DP-INVENTIONS/DP-Ventilator/README.md

# DP-Ventilator
Open Source BVM based ventilator
