DP-INVENTIONS/DP-Ventilator/DPvent 23052020 BOM.xlsx

VENTILATOR
ITEM NO. | PARTGROUP | PART NUMBER | Reseller | PRICE | DESCRIPTION | QTY. | Total
1 | Front | NX4827K043_011R | Tinytronics | 56 | Nextion touchscreen 4.3" 480x272 65536 colors | 1 | 56
2 | Front | KY-040 | Aliexpress | 1 | Rotary encounter EC11 20mm with push button on pcb | 1 | 1
3 | Front | KNOPBKWH | Tinytronics | 0.5 | Button knob (white) | 1 | 0.5
4 | Front | CKN12299-ND | Digikey | 6.63 | SWITCH ANTIVANDAL 16MM DOME RING | 1 | 6.63
5 | Front | NgenGray 1.75 | OMD3D | 40 | canvas layer Ngen filament gray | 0.1 | 4
6 | Front | NgenGray 1.75 | OMD3D | 40 | Front layer Ngen filament gray | 0.1 | 4
7 | Cabinet | NSYTBS241912H | Farnell | 20.8 | Schneider Thalassa PLS enclosure 241 mm, 194 mm, 127 mm, IP66 | 1 | 20.8
8 | Cabinet | RDMEGAXPRO-USBB | Tinytronics | 15 | RobotDyn MegaXPRO R3 - Compatible - USB-B | 1 | 15
9 | Cabinet | DCDCSTEPDOWN5V | Tinytronics | 3 | DC-DC Step-down Buck Converter 1.5A - 5V output | 1 | 3
10 | Cabinet | EB40202S2-999 | Tinytronics | 5 | Sunon Ventilator 40x40x20mm - 24V | 1 | 5
11 | Cabinet | 5VBUZMOD | Tinytronics | 1.5 | Actieve Buzzer Module 5V | 1 | 1.5
12 | Cabinet | DC5.5FMOUNT | Tinytronics | 0.5 | DC Jack plastic 5.5mm - Female - Mount | 1 | 0.5
13 | Cabinet | RJ45 socket | Aliexpress | 2 | RJ45 Waterproof Connector Female Panel Mount Sockets Ethernet Straight | 1 | 2
14 | Cabinet | 2278 | DamenCNC | 108.89 | Leadshine Digital Stepper Drive DM856 80V 5,6A (2phase) | 1 | 108.89
15 | Cabinet | 674 | DamenCNC | 114.94 | Stepper Motor DCNC-NEMA34-4.5Nm (Double Shaft) | 1 | 114.94
16 | Cabinet | NgenBlack 1.75 | OMD3D | 40 | Mechanic strap system | 0.5 | 20
17 | Cabinet | NgenWhite 1.75 | OMD3D | 40 | Cover pieces | 0.5 | 20
18 | Cabinet | Axe 8mm | 123 3Dprint | 22.5 | Lineare axe 8x500mm | 1 | 22.5
19 | Cabinet | Bearing 608ZZ | 123 3Dprint | 6 | 10 bearings 608ZZ | 1 | 6
20 | Cabinet | Screws | Tinytronics | 5 | Set screws | 1 | 5
21 | Cabinet | Power switch | 123 3Dprint | 4 | Schakelaar SPST 5A 250V voor paneelmontage | 1 | 4
22 | Power | GST120A24-P1M | Meanwell | 36.6 | AC-DC adaptor with PFC; Output 24Vdc at 5A; 3 pole AC inlet IEC320-C14 | 1 | 36.6
23 | Cabinet | Springs | 123 3Dprint | 2.5 | Schakelaar SPST 5A 250V voor paneelmontage | 4 | 10
24 | Cabinet | NgenWhite 1.75 | Meanwell | 15 | Springhouse left and right | 1 | 15
25 | Cabinet | Strapbelt | - | 7 | Strap witdh 20mm/ 1mm thick | 1 | 7
 |  |  |  |  |  | Totaal | 489.86
 |  |  |  |  |  |  | Estimated cost
Printed parts
ITEM NO. | PARTGROUP | MATERIAL | Alternatif | Time to build | DESCRIPTION | QTY. | Total
5 | Front | NgenGray 1.75 | - | 15:00:00 | Front canvas | 1 | 15:00:00 | 15
6 | Front | NgenGray 1.75 | Lasercut | 3:00:00 | Front | 1 | 3:00:00 | 3
16 | Cabinet | NgenBlack 1.75 | Lasercut | 5:30:00 | table | 1 | 5:30:00 | 5.5
16 | Cabinet | NgenBlack 1.75 | Lasercut | 8:30:00 | Motorplate | 1 | 8:30:00 | 8.5
16 | Cabinet | NgenBlack 1.75 | Lasercut | 9:40:00 | Gearplate | 1 | 9:40:00 | 9.5
16 | Cabinet | NgenGray 1.75 | cute out of tube | 5:00:00 | 4 guiding Rolls | 1 | 5:00:00 | 5
16 | Cabinet | NgenGray 1.75 | CNC | 1:40:00 | Gearing roll | 1 | 1:40:00 | 1.5
16 | Cabinet | Ngenblack 1.75 | Lasercut | 3:30:00 | Plate holders and covers | 1 | 3:30:00 | 3.5
17 | Cabinet | NgenWhite 1.75 | Lasercut | 13:40:00 | Top plate cover enclosure + tube holders left right | 1 | 13:40:00 | 13.5
17 | Cabinet | NgenWhite 1.75 | - | 2:40:00 | Underbow tube | 1 | 2:40:00 | 2.5
17 | Cabinet | NgenWhite 1.75 | - | 7:30:00 | Bridgepusher | 1 | 7:30:00 | 7.5
17 | Cabinet | NgenWhite 1.75 | - | 2:00:00 | Bridgetopplate | 1 | 2:00:00 | 2
17 | Cabinet | NgenWhite 1.75 | - | 2:00:00 | Bridge strapholders | 1 | 2:00:00 | 2
17 | Cabinet | NgenGray 1.75 | Lasercut | 6:40:00 | Bridge pilars | 1 | 6:40:00 | 7
24 | Cabinet | NgenWhite 1.75 | - | 13:00:00 | Spring houses | 1 | 13:00:00 | 13
 |  |  |  |  |  | Totaal | 99.00
 |  |  |  |  | Could be less if some parts will be laser cutted |  | Printing hours
BATTERY BACKUP
ITEM NO. | PARTGROUP | PART NUMBER | Reseller | PRICE | DESCRIPTION | QTY. | Total
26 | Front | TM1683 | Tinytronics | 9 | Led/Key board | 1 | 9
27 | Front | NgenGray 1.75 | OMD3D | 40 | canvas layer Ngen filament gray | 0.1 | 4
28 | Front | NgenGray 1.75 | OMD3D | 40 | Front layer Ngen filament gray | 0.1 | 4
29 | Cabinet | NSYTBS241910H | Farnell | 20.8 | Schneider Thalassa PLS enclosure 241 mm, 194 mm, 80 mm, IP66 | 1 | 20.8
30 | Cabinet |  | Tinytronics | 15 | RobotDyn UNO - Compatible - USB-B | 1 | 15
31 | Cabinet | DCDCSTEPDOWN5V | Tinytronics | 3 | DC-DC Step-down Buck Converter 1.5A - 5V output | 1 | 3
32 | Cabinet | EB40202S2-999 | Tinytronics | 5 | Sunon Ventilator 40x40x20mm - 24V | 1 | 5
33 | Cabinet | 5VBUZMOD | Tinytronics | 1.5 | Actieve Buzzer Module 5V | 1 | 1.5
34 | Cabinet | DC5.5FMOUNT | Tinytronics | 0.5 | DC Jack plastic 5.5mm - Female - Mount | 1 | 0.5
35 | Cabinet | Power switch | 123 3Dprint | 4 | Schakelaar SPST 5A 250V voor paneelmontage | 1 | 4
36 | Cabinet | Battery | - | 24 |  | 2 | 48
37 | Cabinet | DCDC supply UPS | 123 3Dprint | 45 |  | 1 | 45
38 | Cabinet | NgenBlack 1.75 | OMD3D | 2 | Feets Ngen filamennt black | 1 | 2
39 | Cabinet | Screws | Tinytronics | 2 | Set screws | 1 | 2
 |  |  |  |  |  | Totaal | 163.8
 |  |  |  |  |  |  | Estimated cost
Printed parts
ITEM NO. | PARTGROUP | MATERIAL | Alternatif | Time to build | DESCRIPTION | QTY. | Total
24 | Front | NgenGray 1.75 | - | 15:00:00 | Front canvas | 1 | 15:00:00 | 15
24 | Front | NgenGray 1.75 | - | 3:00:00 | Front | 1 | 3:00:00 | 3
38 | Cabinet | NgenBlack 1.75 | - | 2:00:00 | Voetjes | 1 | 2:00:00 | 2
 |  |  |  |  |  | Totaal | 20.00
 |  |  |  |  |  |  | Printing hours
