DP-INVENTIONS/DP-Ventilator/stl/HAAKJE.stl

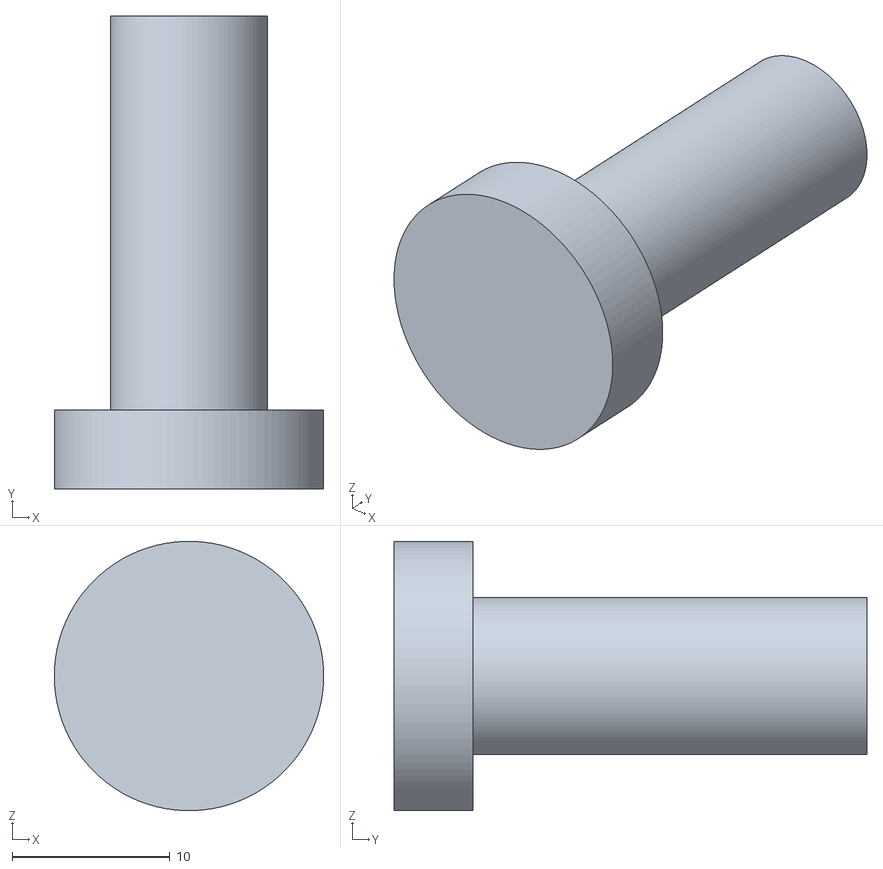
[picture p1: CAD file, 2020-05-24]
stl/HAAKJE.stl
17.1 x 30.0 x 17.1
