DP-INVENTIONS/DP-Ventilator/stl/TAFEL2.stl

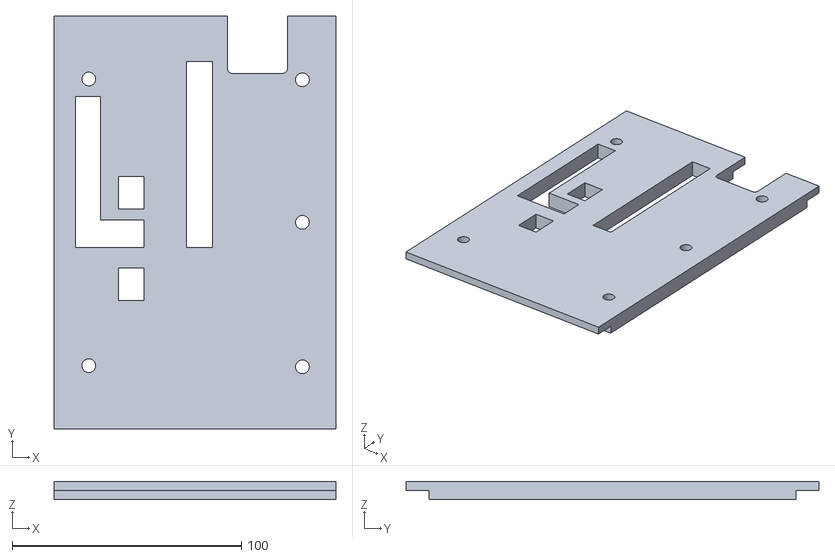
[picture p2: CAD file, 2020-05-24]
stl/TAFEL2.stl
122.9 x 180.1 x 8.00
