DP-INVENTIONS/DP-Ventilator/stl/CLIPS.stl

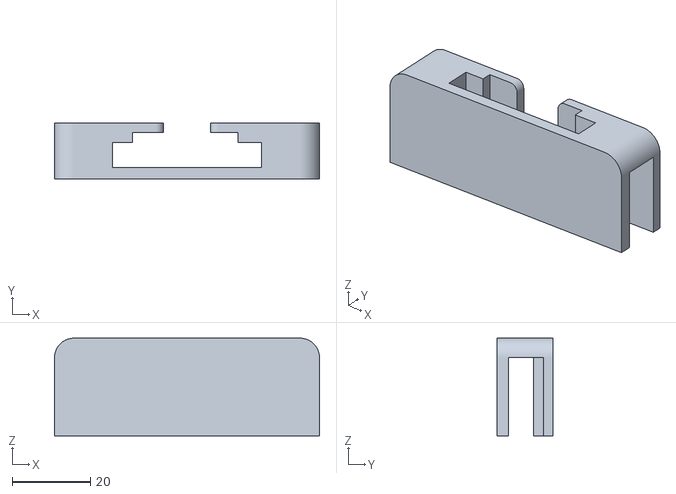
[picture p3: CAD file, 2020-05-24]
stl/CLIPS.stl
67.8 x 14.4 x 25.0
