DP-INVENTIONS/DP-Ventilator/stl/BALGSTEUN.stl

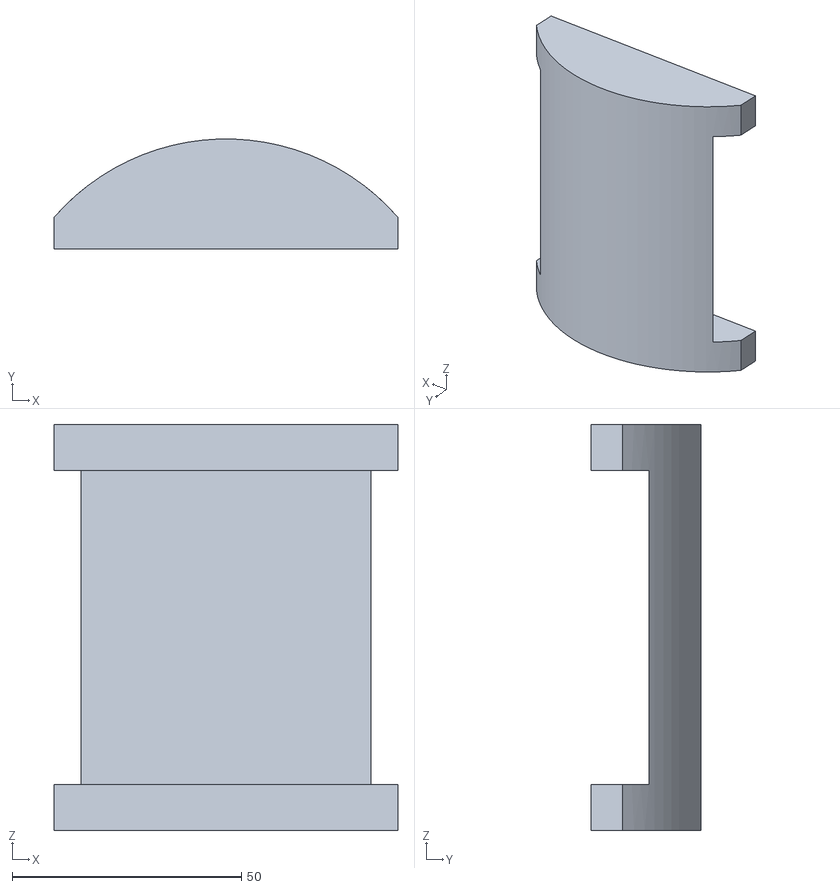
[picture p4: CAD file, 2020-05-24]
stl/BALGSTEUN.stl
75.0 x 24.0 x 88.5
