DP-INVENTIONS/DP-Ventilator/stl/TOP_KAST.stl

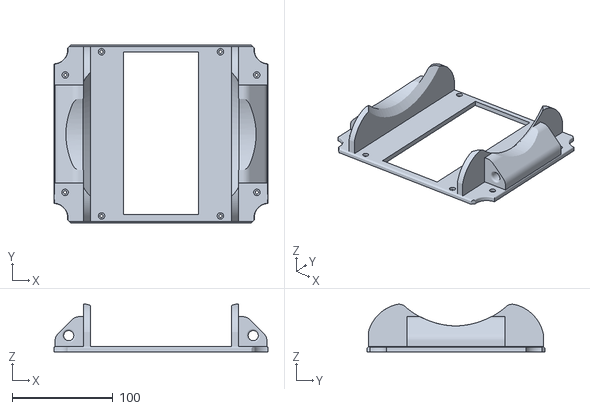
[picture p5: CAD file, 2020-05-24]
stl/TOP_KAST.stl
211.9 x 176.4 x 47.1
