DP-INVENTIONS/DP-Ventilator/stl/MOTORPLAAT.stl

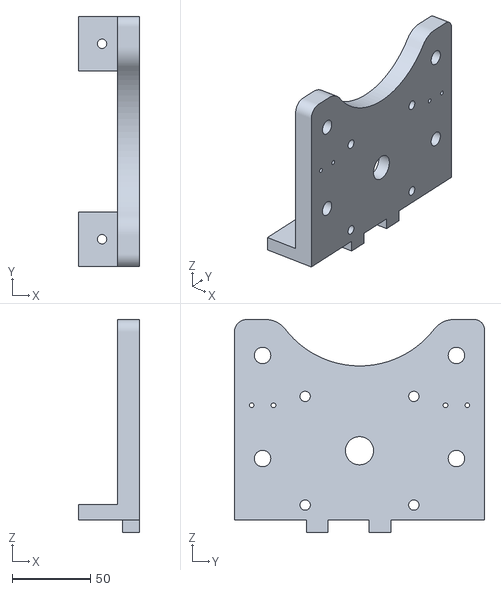
[picture p6: CAD file, 2020-05-24]
stl/MOTORPLAAT.stl
39.1 x 160.0 x 136.2
