DP-INVENTIONS/DP-Ventilator/stl/TAFEL3.stl

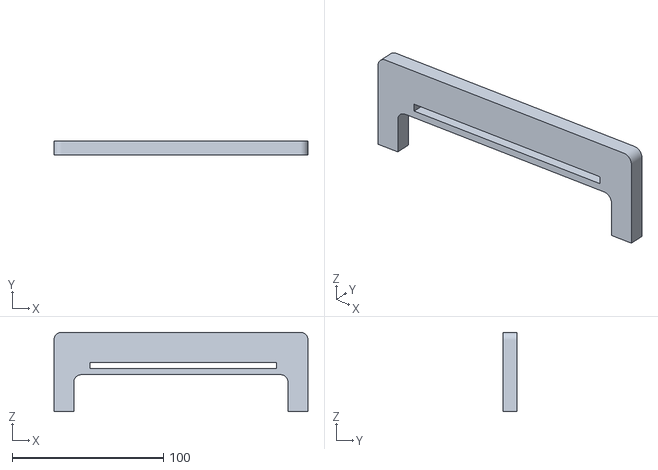
[picture p7: CAD file, 2020-05-24]
stl/TAFEL3.stl
167.9 x 9.00 x 52.5
