DP-INVENTIONS/DP-Ventilator/stl/VEERPUSHER.stl

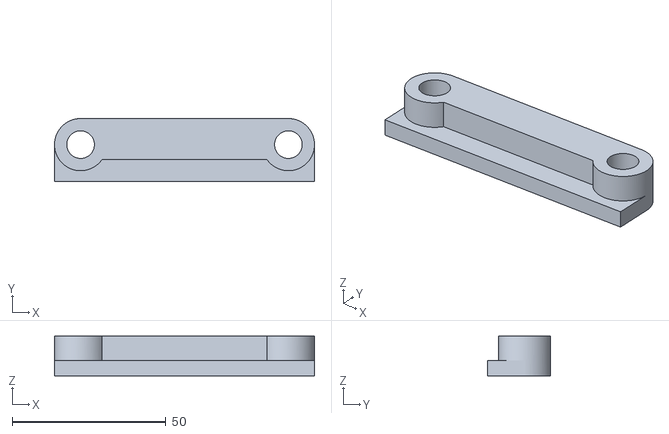
[picture p8: CAD file, 2020-05-24]
stl/VEERPUSHER.stl
84.7 x 20.5 x 13.0
