DP-INVENTIONS/DP-Ventilator/stl/SD_HOUDER2.stl

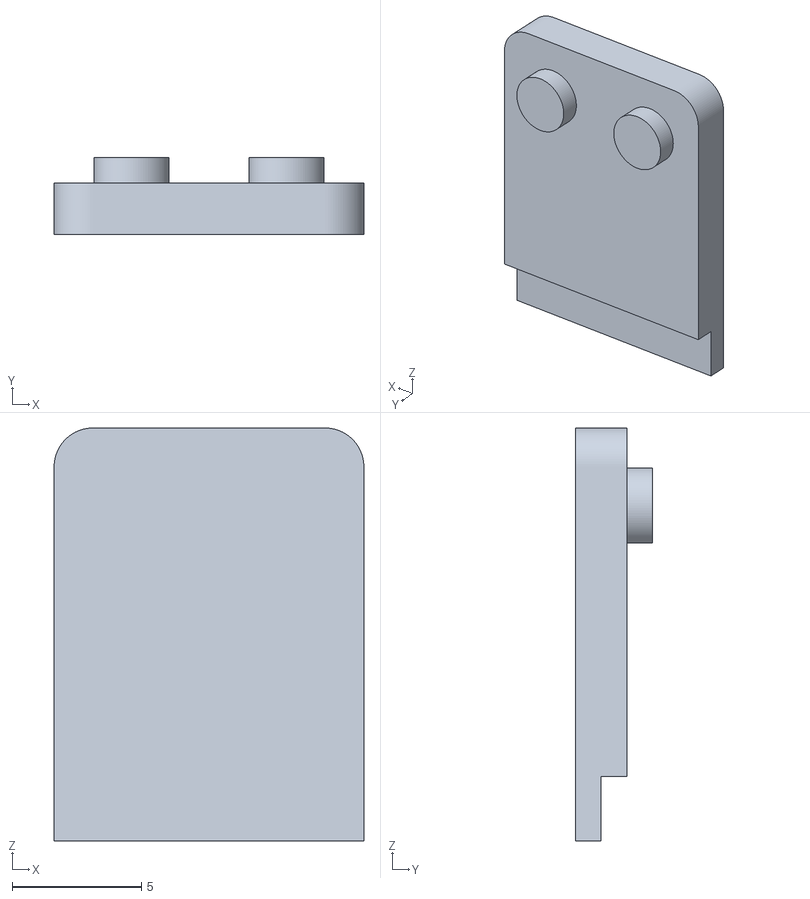
[picture p9: CAD file, 2020-05-24]
stl/SD_HOUDER2.stl
12.0 x 3.00 x 16.0
