DP-INVENTIONS/DP-Ventilator/stl/SD_HOUDER1.stl

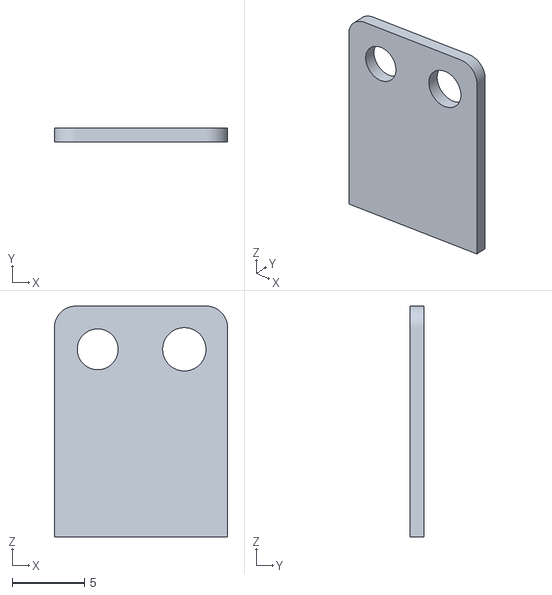
[picture p10: CAD file, 2020-05-24]
stl/SD_HOUDER1.stl
12.0 x 1.00 x 16.0
