DP-INVENTIONS/DP-Ventilator/stl/VEERKAMER.stl

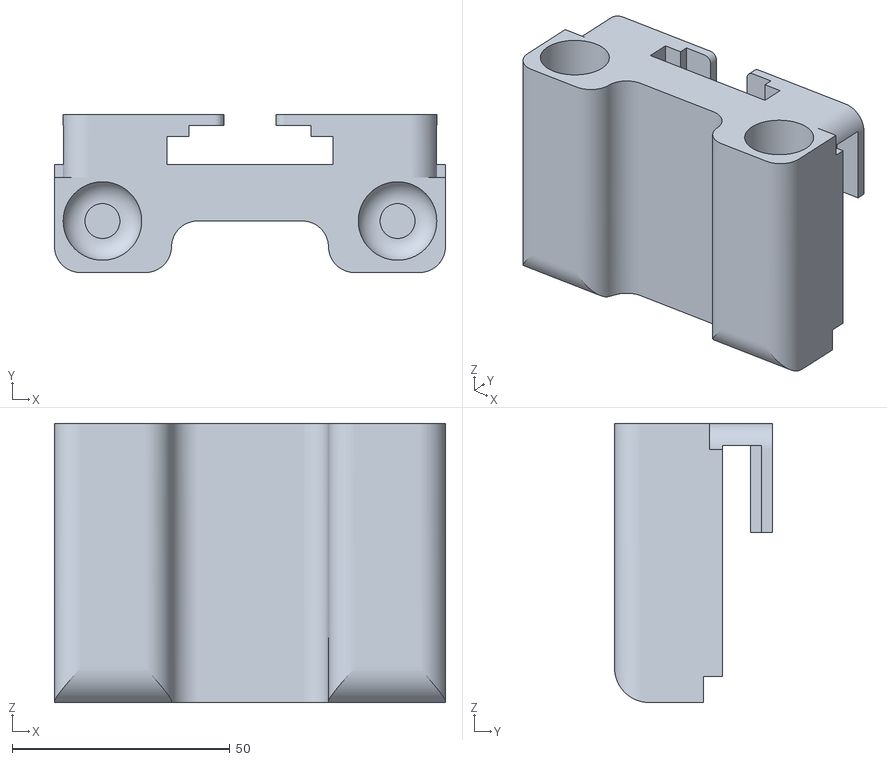
[picture p11: CAD file, 2020-05-24]
stl/VEERKAMER.stl
89.7 x 36.3 x 64.0
