DP-INVENTIONS/DP-Ventilator/stl/GELEIDER.stl

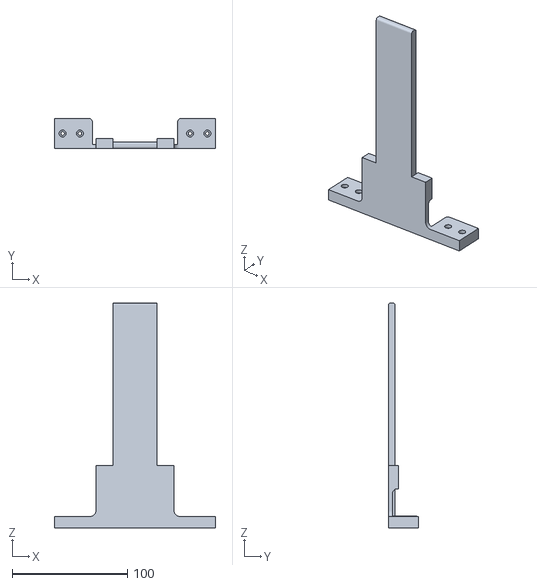
[picture p12: CAD file, 2020-05-24]
stl/GELEIDER.stl
139.8 x 26.2 x 195.0
