DP-INVENTIONS/DP-Ventilator/stl/FRONTL1.stl

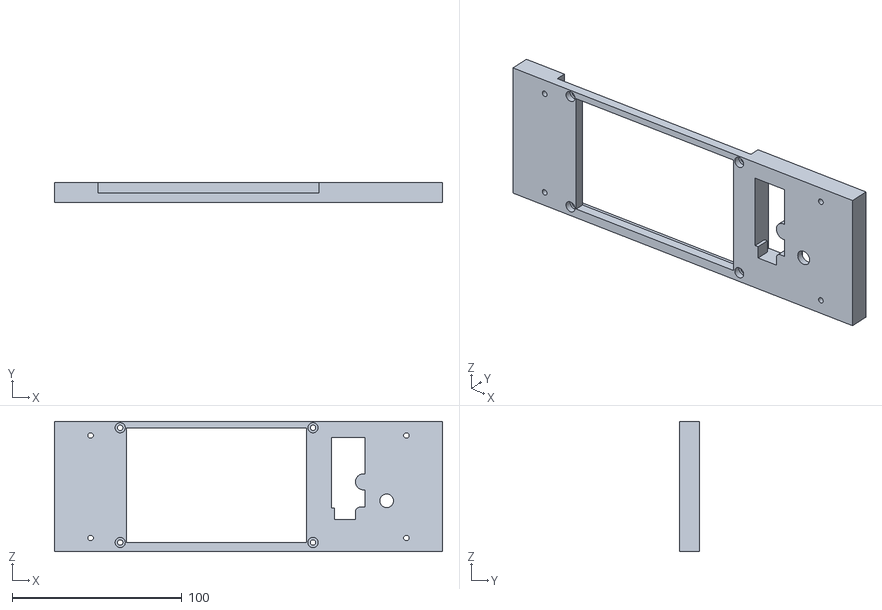
[picture p13: CAD file, 2020-05-24]
stl/FRONTL1.stl
228.6 x 11.6 x 76.7
