DP-INVENTIONS/DP-Ventilator/stl/TOPBRUG.stl

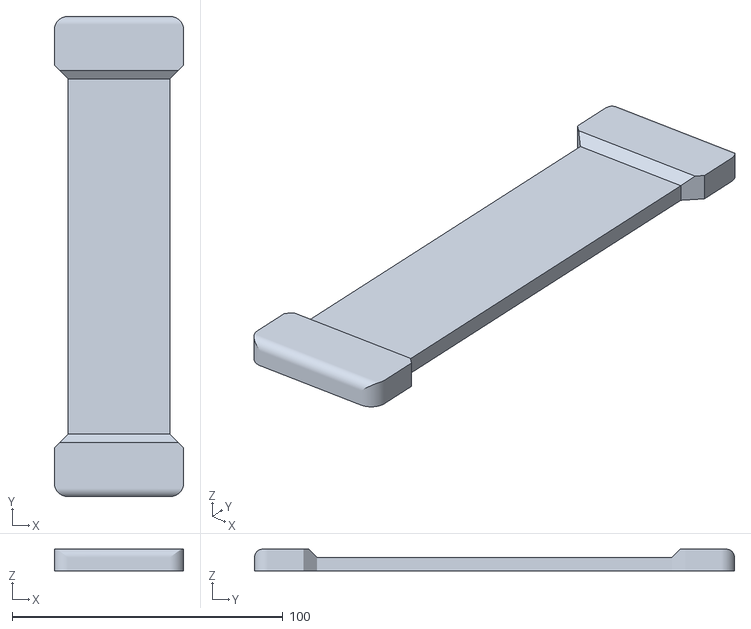
[picture p14: CAD file, 2020-05-24]
stl/TOPBRUG.stl
47.8 x 177.2 x 8.00
