DP-INVENTIONS/DP-Ventilator/stl/HOOFDROL.stl

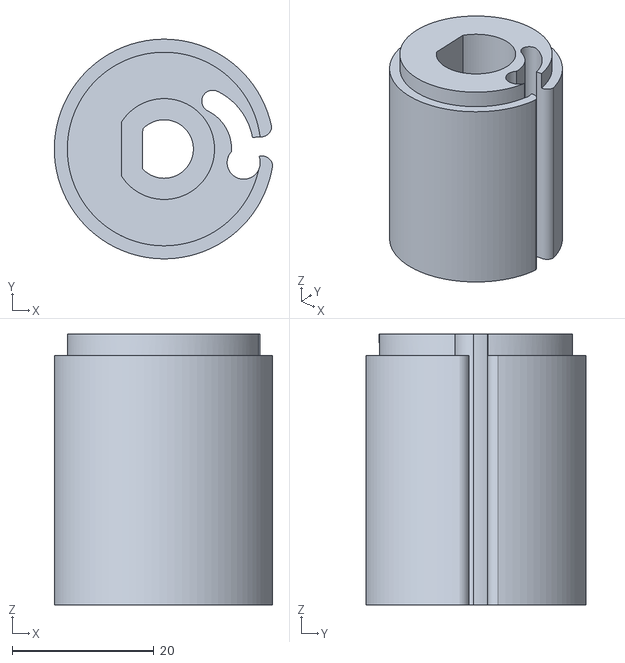
[picture p15: CAD file, 2020-05-24]
stl/HOOFDROL.stl
30.8 x 31.0 x 38.2
