DP-INVENTIONS/DP-Ventilator/stl/MOTORPLAAT2.stl

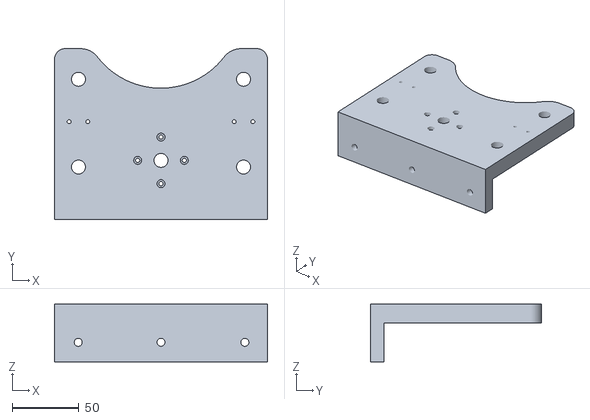
[picture p16: CAD file, 2020-05-24]
stl/MOTORPLAAT2.stl
160.0 x 128.2 x 43.2
