DP-INVENTIONS/DP-Ventilator/stl/FRONTL2.stl

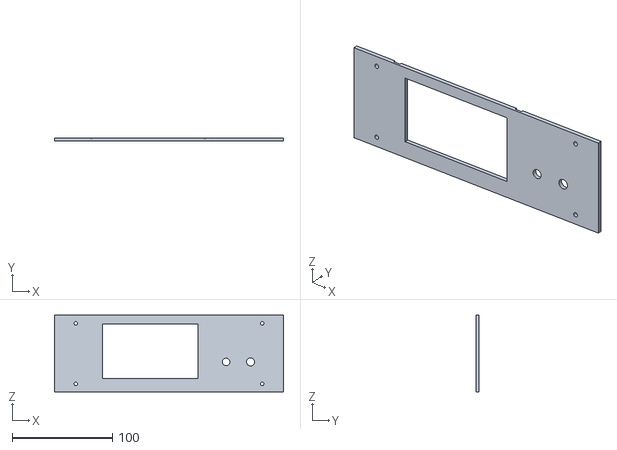
[picture p17: CAD file, 2020-05-24]
stl/FRONTL2.stl
228.6 x 3.20 x 76.7
