DP-INVENTIONS/DP-Ventilator/stl/FRONTKADER.stl

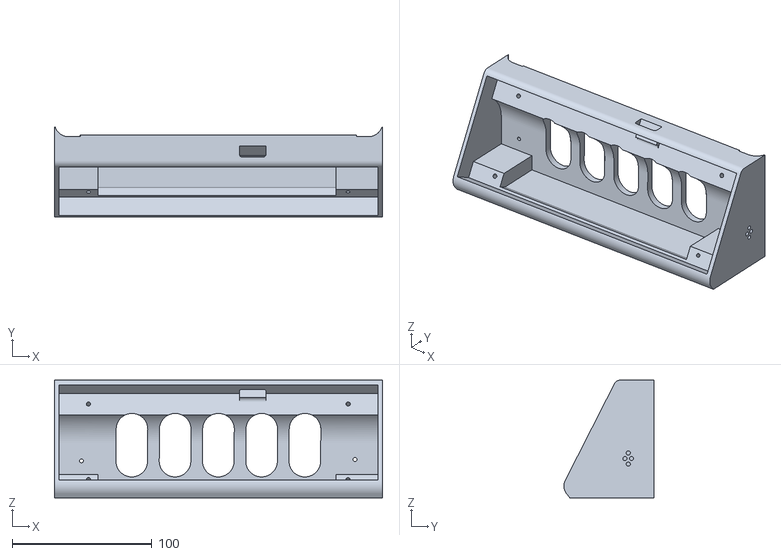
[picture p18: CAD file, 2020-05-24]
stl/FRONTKADER.stl
235.0 x 64.7 x 84.4
