DP-INVENTIONS/DP-Ventilator/stl/VEERAFDEK.stl

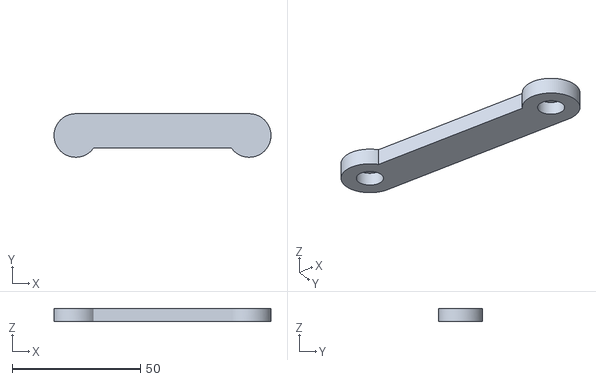
[picture p19: CAD file, 2020-05-24]
stl/VEERAFDEK.stl
84.7 x 17.0 x 5.00
