DP-INVENTIONS/DP-Ventilator/stl/AANDRUKPAD.stl

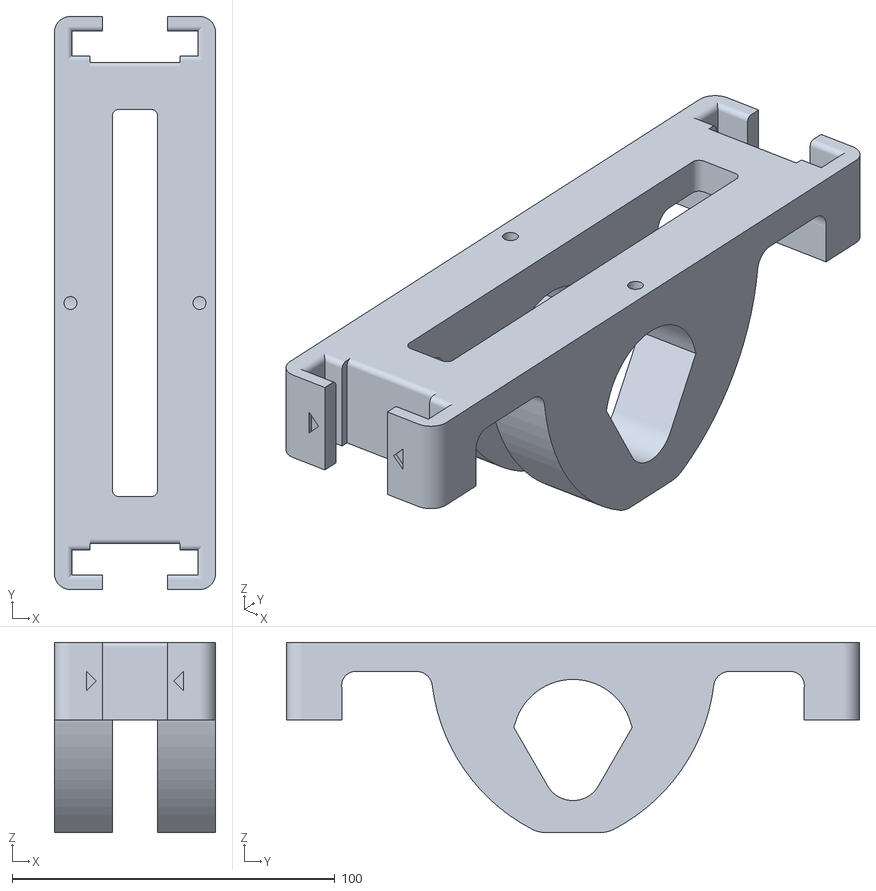
[picture p20: CAD file, 2020-05-24]
stl/AANDRUKPAD.stl
50.0 x 177.6 x 59.0
