DP-INVENTIONS/DP-Ventilator/(list of files, cad)

Other CAD files:
stl/TAFEL1.stl
