DP-INVENTIONS/DP-Ventilator/schematics/Schematic_DP-ventilator_2020-05-23_21-55-53.pdf

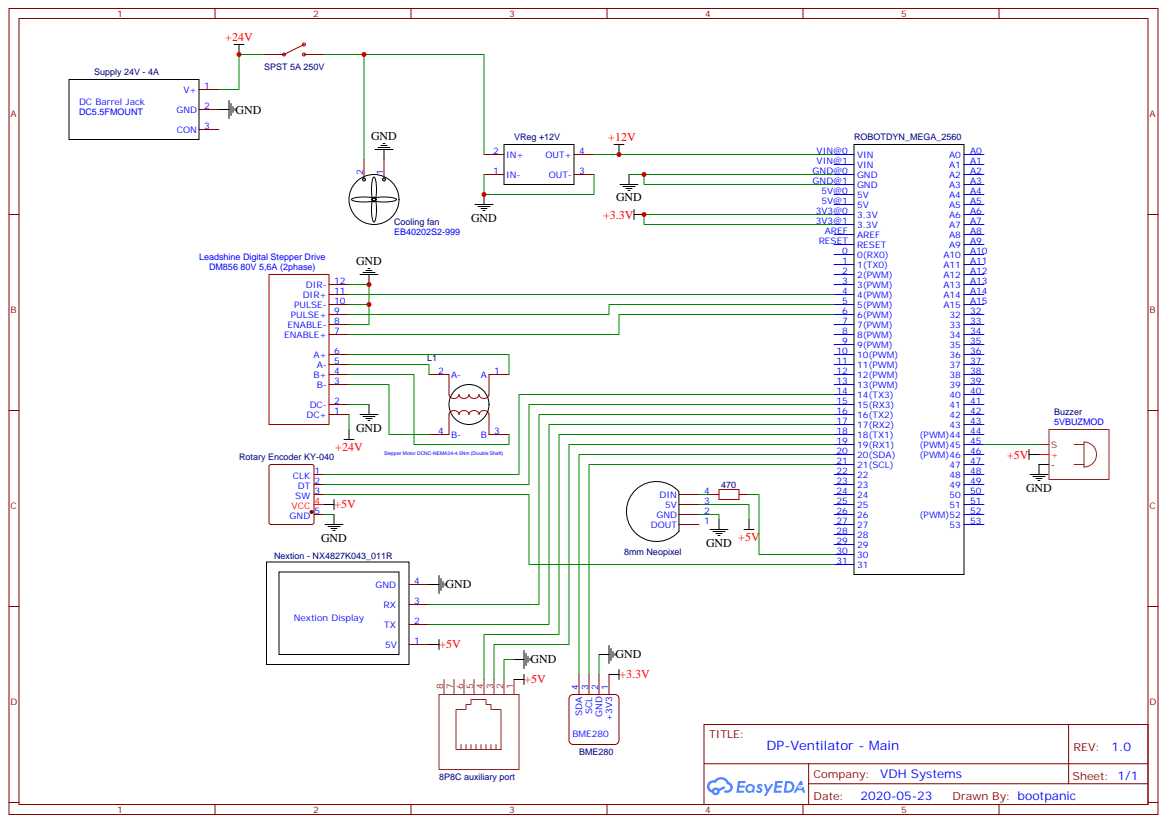
[picture p21: page 1]

Leadshine Digital Stepper Drive
DM856 80V 5,6A (2phase)

Stepper Motor DCNC-NEMA34-4.5Nm (Double Shaft)
