DP-INVENTIONS/DP-Ventilator/(commit log)

2020-05-23 Create schematics
2020-05-24 update 2020-05-24_02
    [AANDRUKPAD.stl, BALGSTEUN.stl, CLIPS.stl, FRONTKADER.stl, FRONTL1.stl, FRONTL2.stl, GELEIDER.stl, HAAKJE.stl]
